AxelBjork/balancer_bot/doc/arch/send_path_asm_analysis.md

# IPC Send Path Assembly Analysis (-O3)

This document analyzes the generated x86-64 assembly of the SIL application's IPC send path, from a publisher calling `bus.publish()` down to the `sendmsg()` system call in the UDP Bridge, when compiled with `-O3` optimizations. The implementation is hyper-optimized for zero dynamic allocations and zero user-space memory copies.

## Complete Send Path Trace

When a service (for example, `RevisionService`) publishes a message, the following execution path occurs:

### 1. The Publisher Call
The publisher calls `bus.publish<MsgId::RevisionResponse>(payload)`. This forwards a `const void*` pointer pointing to the payload into `ipc::MessageBus::dispatch(MsgId, const void*)`. 

Because `dispatch` handles all message types symmetrically, it is compiled as a distinct out-of-line function (`<ipc::MessageBus::dispatch>`).

### 2. MessageBus `dispatch` (The Core Loop)
Inside `MessageBus::dispatch`, the code performs a lock-free lookup in the `std::unordered_map` to find the `std::vector<std::function>` associated with the `MsgId`.

Once the vector is found, the assembly loops through it. The compiler generates an indirect jump to the type-erased `std::function` handler:
```nasm
  # Setup loop bounds
  mov    rbx,QWORD PTR [rax+0x10]  # rbx = std::vector::begin()
  mov    rbp,QWORD PTR [rax+0x18]  # rbp = std::vector::end()

  # ... loop condition ...

  # The Indirect Call
  mov    rdi,rbx                   # rdi = functor lambda pointer
  mov    rsi,r12                   # rsi = const void* payload pointer
  call   QWORD PTR [rbx+0x18]      # Indirect jump to std::function handler
```
**Optimization Analysis:** Because the `handlers_` map holds type-erased function pointers, the compiler cannot devirtualize this call, even with aggressive inlining. The jump is inherently dynamic. This is the primary (and virtually only) overhead of the `MessageBus` design.

### 3. The `std::function` Handler (`forward_to_udp` lambda)
The indirect call lands inside the `<lambda(const void*)>::_M_invoke` function generated for `UdpBridge`.

This function acts entirely lock-free and zeroes out copying overhead:
1. **Atomic Peer Check**: It verifies the UDP active peer safely.
2. **`msg_hdr` and `iovec` Stack Emplacement**: It builds the vector arrays on the stack, forwarding exactly what the typed payload pointer views.
3. **Socket Send**: Calls `sendmsg()`.

```nasm
<std::_Function_handler<void (RevisionResponsePayload const&), ...>::_M_invoke(std::_Any_data const&, RevisionResponsePayload const&)>:
	mov    (%rdi),%rdx                # 1. Lock-free load of active peer (packed 64-bit struct representing IP + Port)
	mov    0x20(%rdx),%rax
	mov    %rax,%rcx
	shr    $0x20,%rcx
	test   %cx,%cx
	jne    <..._M_invoke+0x1b>		  # If ip and port are 0, return
	test   %eax,%eax
	je     <..._M_invoke+0xc0>
	sub    $0x88,%rsp				 # 2. Setup local structs (sockaddr_in, msghdr, and iovec[2])
	mov    $0x2,%edi
	pxor   %xmm0,%xmm0
	mov    $0x7d1,%r8d          	 # MsgId = 2001 (RevisionResponse)
	mov    %eax,0x14(%rsp)
	lea    0xe(%rsp),%rax
	movq   $0x0,0x18(%rsp)
	mov    %di,0x10(%rsp)
	mov    0x8(%rdx),%edi
	xor    %edx,%edx
	mov    %rax,0x20(%rsp)    	     # 3. Build iovec array and msghdr
	lea    0x10(%rsp),%rax
	mov    %rsi,0x30(%rsp)
	lea    0x40(%rsp),%rsi
	mov    %rax,0x40(%rsp)
	lea    0x20(%rsp),%rax
	movups %xmm0,0x4c(%rsp)
	movups %xmm0,0x5c(%rsp)
	mov    %cx,0x12(%rsp)
	mov    %r8w,0xe(%rsp)        	 # Store MsgId to local stack buffer
	movq   $0x2,0x28(%rsp)       	 # iov[0].iov_len = 2
	movq   $0x41,0x38(%rsp)      	 # iov[1].iov_len = 65 (sizeof(RevisionResponsePayload))
	movl   $0x10,0x48(%rsp)
	mov    %rax,0x50(%rsp)
	movq   $0x2,0x58(%rsp)
	movups %xmm0,0x68(%rsp)
	call   <sendmsg@plt>	 	 	 # 4. Trigger the syscall
	add    $0x88,%rsp
	ret
	nopw   0x0(%rax,%rax,1)
	nop
	nopl   (%rax)
	data16 cs nopw 0x0(%rax,%rax,1)
```

**Optimization Analysis:** This optimization is beautiful. 
- **Zero Allocations:** There are no `operator new` instantiations. Everything is placed exclusively on the 136-byte stack allocation.
- **Zero Copies:** There are absolutely zero `memcpy` operations. Instead of concatenating the MsgId and Payload into a single memory block first, the generated assembly constructs scatter/gather structures natively mapped into `iovec`. 
- **Template Devirtualization:** Because `RevisionResponse` is templated, the compiler has resolved `sizeof(Payload)` to a hardcoded constant (`0x41` or 65 bytes) and the `MsgId` literal `0x7d1` (2001).

### 4. The System Call Boundary
Immediately after preparing the scatter-gather definitions on the stack, the system jumps via PLT wrapper straight into the Linux Kernel.

```nasm
	call   <sendmsg@plt>         # PLT jump into libc / kernel
```

From here, execution traps into the Linux kernel (crossing via `syscall`). The kernel itself copies the fragments of memory mapped by `iovec` into a continuous kernel socket buffer (`sk_buff`) and loops it back over the `lo` loopback interface to Python (Pytest).

---

## Conclusions on Performance

- **The Good**: Serialization is virtually free, and completely eradicates user-space copying. Memory alignment and layout rules allow the compiler to map the `const void*` pointer natively across the kernel boundary.
- **The Overhead**: The abstraction of `MessageBus` (using `std::function` callback arrays) acts as an optimization barrier. The compiler cannot pierce the type erasure inside the dynamic vector, resulting in an unavoidable indirect call (`call QWORD PTR [...]`) for every subscriber.
- **Verdict**: For an application running at 100Hz, the cost of one indirect branch predictor miss per message dispatch is negligible (on the order of nanoseconds), whereas the zero copy pointer dispatch natively coalescing into UDP payloads guarantees we save significant CPU time, avoid cache pollution, and delete dynamic allocations entirely.

---

## 5. UdpBridge::rx_loop
This is a quick look at how the receiving loop manages to update the `active_peer_` without needing a mutex lock, exclusively using a native 64-bit atomic instruction path.

```nasm
<ipc::UdpBridge::rx_loop() + rx handler>:
	call   <recvfrom@plt>
	movdqa (%rsp),%xmm0
	test   %rax,%rax
	js     <...rx_loop()+0x16>
	mov    0x34(%rsp),%edi          # Load sender ip
	cmp    %edi,0x24(%rbx)          # Compare with current local loop cache
	jne    <...rx_loop()+0x153>     # If different... jump to update
	movzwl 0x32(%rsp),%edi          # Load sender port
	cmp    %di,0x22(%rbx)           # Compare
	je     <...rx_loop()+0x16b>

    # (Update path...)
	mov    0x30(%rsp),%rax          # Load incoming sender sockaddr tightly into %rax
	mov    %rax,0x20(%rbx)          # Atomic store to active_peer_!
```
Because `active_peer_` is packed into an 8-byte `PeerAddress` wrapper struct, the entire thread synchronization is reduced entirely to a single `mov` instruction (`mov %rax, 0x20(%rbx)`).
