AxelBjork/balancer_bot/hardware/frame/B-robot_EVO_2/Top_Shelf_[V10.stl

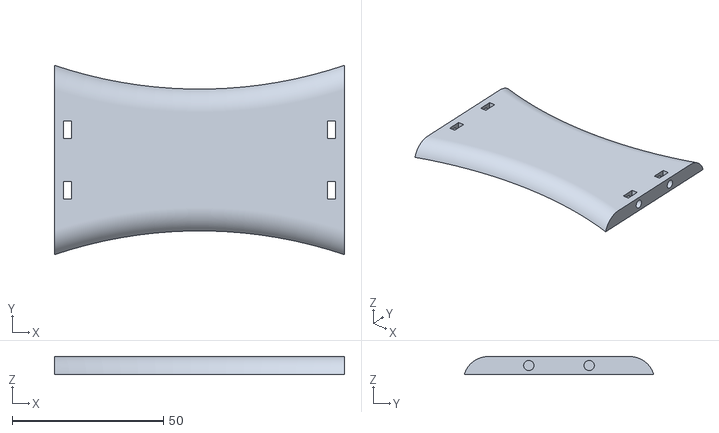
[picture p1: CAD file, 2025-08-23]
hardware/frame/B-robot_EVO_2/Top_Shelf_[V10.stl
96.0 x 62.7 x 6.00
