AxelBjork/balancer_bot/hardware/frame/custom/bumper_V3.stl

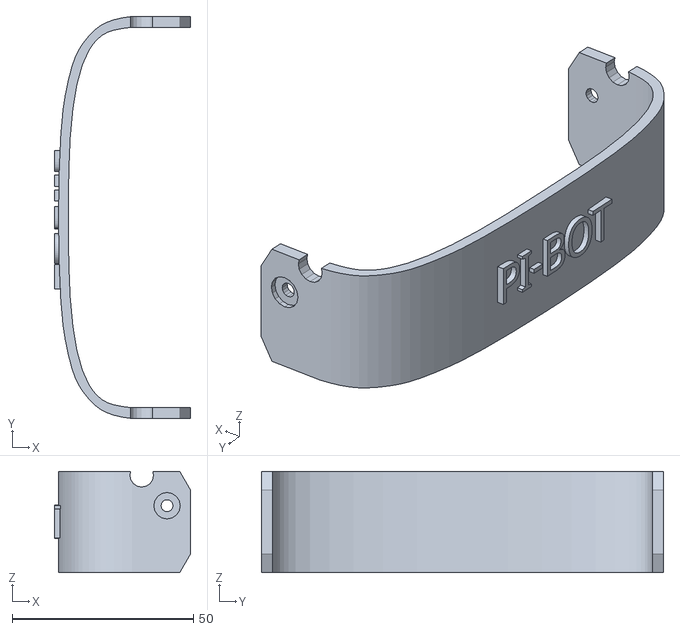
[picture p2: CAD file, 2025-08-23]
hardware/frame/custom/bumper_V3.stl
37.6 x 111.0 x 28.0
