AxelBjork/balancer_bot/hardware/frame/B-robot_EVO_2/Hub_[V10_ENLARGED.stl

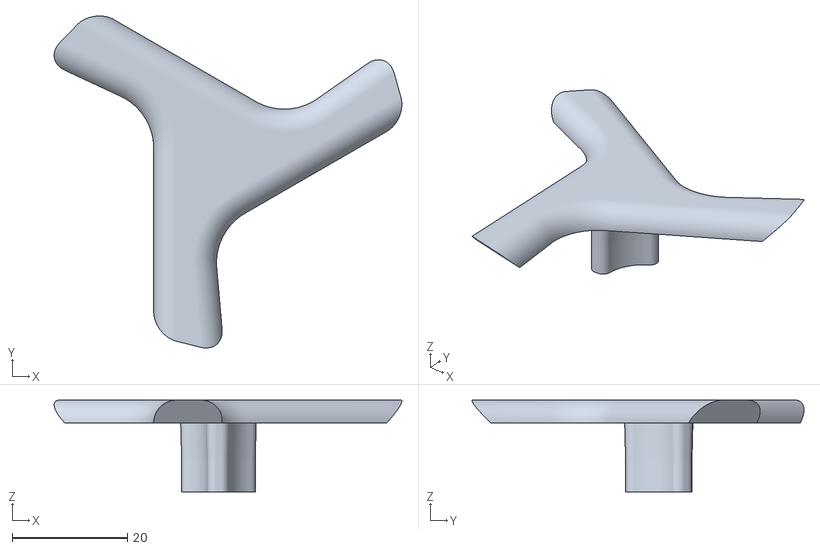
[picture p3: CAD file, 2025-08-23]
hardware/frame/B-robot_EVO_2/Hub_[V10_ENLARGED.stl
60.4 x 57.6 x 15.9
