AxelBjork/balancer_bot/hardware/frame/custom/side_panel_18650_v3.stl

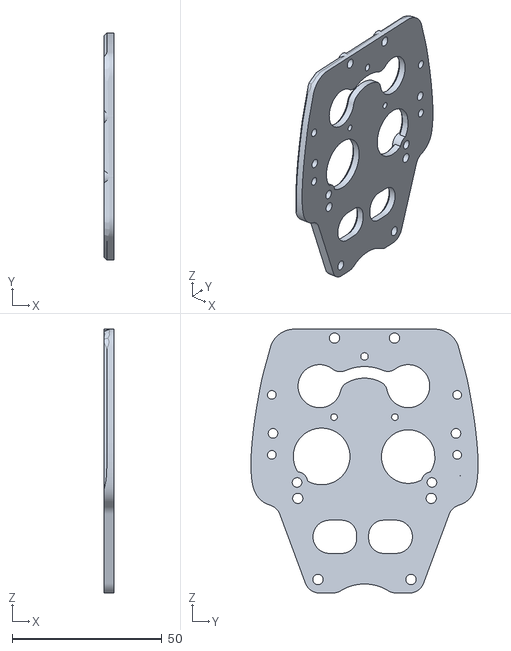
[picture p4: CAD file, 2025-08-23]
hardware/frame/custom/side_panel_18650_v3.stl
3.50 x 75.7 x 88.0
