AxelBjork/balancer_bot/hardware/frame/B-robot_EVO_2/Motor_Shelf_[V10.stl

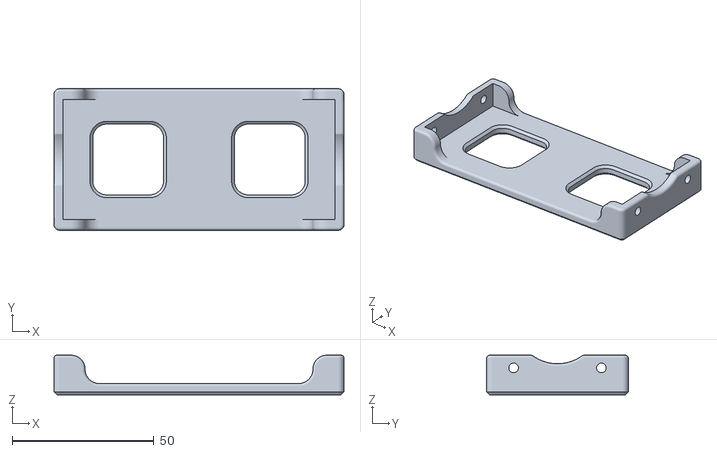
[picture p5: CAD file, 2025-08-23]
hardware/frame/B-robot_EVO_2/Motor_Shelf_[V10.stl
102.4 x 50.0 x 14.0
