AxelBjork/balancer_bot/hardware/frame/custom/pi_shelf_modded.stl

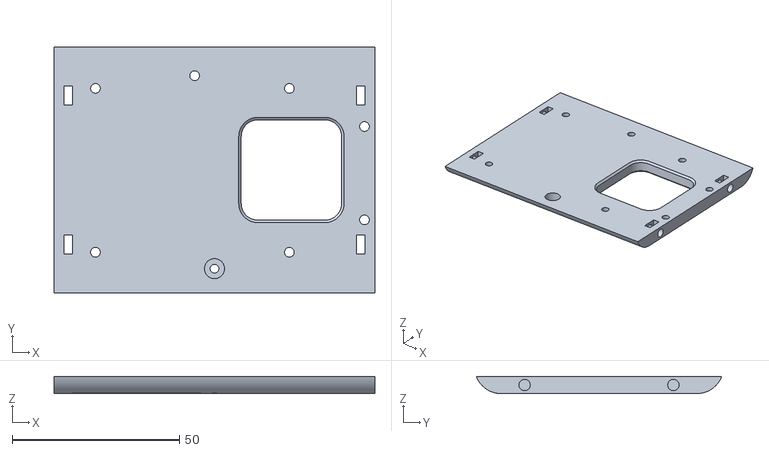
[picture p6: CAD file, 2025-08-23]
hardware/frame/custom/pi_shelf_modded.stl
96.0 x 73.5 x 5.15
