AxelBjork/balancer_bot/hardware/frame/B-robot_EVO_2/Wheel_[V11_FOR_O-RING_nytrile.stl

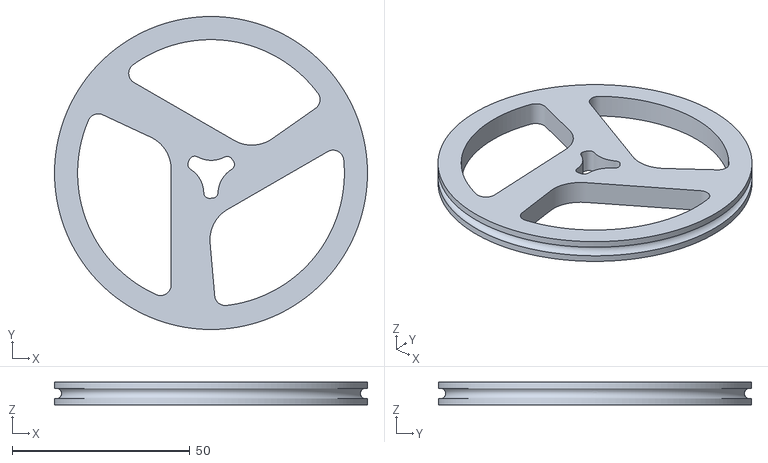
[picture p7: CAD file, 2025-08-23]
hardware/frame/B-robot_EVO_2/Wheel_[V11_FOR_O-RING_nytrile.stl
88.0 x 88.0 x 6.40
