AxelBjork/balancer_bot/tests/data/balance.csv

Starting IMU.
ISM330 requested ODR=833.000000; accel now=833.000000 | gyro now=833.000000
Trigger 'imu833' sampling_frequency now=833.000000
iio:device1: using trigger 'imu833'
iio:device0: using trigger 'imu833'
pitch=0.000° | dpitch=0.000° | yaw=0.000° | time=0.000
Polling for IMU data...
pitch=-88.198° | dpitch=108.163° | yaw=0.122° | time=16391.462
pitch=-86.141° | dpitch=255.646° | yaw=0.262° | time=16391.473
pitch=-83.046° | dpitch=372.118° | yaw=0.009° | time=16391.483
pitch=-78.429° | dpitch=465.046° | yaw=0.175° | time=16391.493
pitch=-73.685° | dpitch=511.833° | yaw=-0.306° | time=16391.503
pitch=-68.651° | dpitch=530.464° | yaw=-0.184° | time=16391.513
pitch=-62.908° | dpitch=529.630° | yaw=-0.122° | time=16391.523
pitch=-57.887° | dpitch=515.899° | yaw=0.481° | time=16391.533
pitch=-52.453° | dpitch=492.161° | yaw=0.350° | time=16391.544
pitch=-47.860° | dpitch=466.770° | yaw=0.271° | time=16391.553
pitch=-43.001° | dpitch=435.624° | yaw=0.306° | time=16391.564
pitch=-38.973° | dpitch=407.309° | yaw=0.586° | time=16391.574
pitch=-35.212° | dpitch=379.239° | yaw=0.560° | time=16391.583
pitch=-31.284° | dpitch=348.295° | yaw=0.227° | time=16391.594
pitch=-28.085° | dpitch=322.142° | yaw=0.271° | time=16391.604
pitch=-25.138° | dpitch=297.122° | yaw=0.411° | time=16391.613
pitch=-22.088° | dpitch=270.585° | yaw=0.507° | time=16391.624
pitch=-19.611° | dpitch=248.290° | yaw=0.446° | time=16391.634
pitch=-17.067° | dpitch=225.166° | yaw=0.236° | time=16391.645
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
pitch=-6.522° | dpitch=-17.197° | yaw=-3.745° | time=16411.017
pitch=-6.699° | dpitch=-15.829° | yaw=-4.025° | time=16411.028
pitch=-6.846° | dpitch=-14.889° | yaw=-3.990° | time=16411.038
pitch=-6.994° | dpitch=-12.688° | yaw=-3.089° | time=16411.048
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
