AxelBjork/balancer_bot/tests/data/imu_data.csv

pitch | dpitch | yaw | time
0.0 | 0.0 | 0.0 | 0.0
-1.5393454936739586 | 1.8878004788346265 | 0.002129301687433082 | 16391.462
-1.5034440709604355 | 4.461864419553423 | 0.004572762640225144 | 16391.473
-1.449426130611211 | 6.494684305936259 | 0.00015707963267948965 | 16391.483
-1.3688442790466329 | 8.11658387322955 | 0.0030543261909900766 | 16391.493
-1.2860458593320219 | 8.933171070360137 | -0.005340707511102648 | 16391.503
-1.1981859847866272 | 9.2583433632992 | -0.0032114058236695662 | 16391.513
-1.0979517258445928 | 9.243787317337567 | -0.002129301687433082 | 16391.523
-1.0103187441019577 | 9.004136157746226 | 0.008395033702092726 | 16391.533
-0.9154775525485858 | 8.589829899907812 | 0.006108652381980153 | 16391.544
-0.8353145800044861 | 8.146673349533932 | 0.0047298422729046335 | 16391.553
-0.7505090316500816 | 7.603073100707778 | 0.005340707511102648 | 16391.564
-0.68020716937975 | 7.108883123005584 | 0.01022762941668677 | 16391.574
-0.6145653362122434 | 6.618969201970775 | 0.009773843811168246 | 16391.583
-0.546008803193906 | 6.078894518233651 | 0.003961897402027128 | 16391.594
-0.4901757204226075 | 5.622438558959573 | 0.0047298422729046335 | 16391.604
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
