AxelBjork/balancer_bot/src/services/main/config.h

#pragma once
#include <atomic>
#include <cmath>

struct AxisCfg {
  int x = 0, y = 1, z = 2;
  bool invert_x = false, invert_y = false, invert_z = false;
};

struct Config {
  // ========= General =========
  static constexpr int run_seconds = 240;
  // Measured wheel geometry and verified driver configuration. Keep this as
  // the single source for production SPS<->distance conversion and the
  // simulator's physical actuator profiles.
  static constexpr double wheel_radius_m = 0.0412;
  static constexpr double wheel_diam_m = 2.0 * wheel_radius_m;
  static constexpr int motor_full_steps_per_rev = 200;
  static constexpr int microsteps_per_full_step = 32;
  static constexpr int commanded_steps_per_rev =
      motor_full_steps_per_rev * microsteps_per_full_step;
  static constexpr double steps_per_rev =
      static_cast<double>(commanded_steps_per_rev);
  static constexpr double meters_per_step =
      2.0 * M_PI * wheel_radius_m / steps_per_rev;
  // Internal scheduler/controller implementation rail.  The checked-in
  // controller configurations continue to use balance_max_sps=16000 while
  // simulator experiments can explore the electrical plant above that
  // nominal balance ceiling without changing the pulse/event representation.
  static constexpr double max_step_rate_sps = 64000.0;
  // The checked-in v12 configs deliberately retain this lower balance limit;
  // it is the fixed comparison surface for controller tuning.
  static constexpr double nominal_balance_max_sps = 16000.0;

  // ========= IMU =========
  static constexpr double sampling_hz = 833.000;  // available 12.5 26 52 104 208 416 833
  static constexpr AxisCfg accel_cfg = {.x = 0, .y = 2, .z = 1, .invert_x = true, .invert_z = true};
  static constexpr AxisCfg gyro_cfg = {.x = 0, .y = 2, .z = 1, .invert_x = true, .invert_z = true};

  static constexpr double g0 = 9.81;
  // The IMU's gyro LPF1 is configured in the ISM330 itself. The software rate
  // path retains only the measured structural notches.
  // No mounting, gyro-bias, gravity-recovery, or COM correction is learned.
  static constexpr double imu_accel_lpf_hz = 15.0;
  static constexpr double imu_gyro_lpf1_bandwidth_hz = 140.0;
  static constexpr int imu_gyro_lpf1_ftype = 0b010;
  // Fixed hardware-mode rejection. These are compiled production constants,
  // not PID-file or runtime estimator parameters.
  static constexpr double imu_gyro_notch_1_center_hz = 26.9;
  static constexpr double imu_gyro_notch_1_bandwidth_hz = 14.0;
  static constexpr double imu_gyro_notch_2_center_hz = 33.4;
  static constexpr double imu_gyro_notch_2_bandwidth_hz = 32.0;
  static constexpr double imu_gyro_derivative_lpf_hz = 10.0;
  // Gravity anchors DC pitch while the gyro carries short-term motion.
  static constexpr double imu_attitude_correction_hz = 0.5;
  static constexpr double imu_gravity_innovation_limit_rad = 2.5 * M_PI / 180.0;
  static constexpr double imu_max_sample_gap_periods = 4.0;
  static constexpr double imu_height_m = 0.070;
  static constexpr bool imu_lever_arm_correction_enabled = false;
  static constexpr double imu_specific_force_min_mps2 = 0.1 * g0;
  static constexpr double imu_specific_force_max_mps2 = 3.5 * g0;
  // Corrected axle velocity is used only by the 100 Hz outer damping/trim loop.
  // 10 Hz removes completed-step quantization without the phase lag that made
  // the proposed 1 Hz filter miss the rocking-disturbance catch.
  static constexpr double fc_velocity_hz = 10.0;

  // ========= Controller rates & limits =========
  static constexpr int control_hz = 400;  // Main control loop frequency
  // Pulse frequency can change much faster than the wheel itself; the phase-
  // error/missed-step plant supplies the physical acceleration limit.
  static constexpr double motor_slew_sps_per_s = 200000.0;
  // High field-speed requests may briefly spend a bounded actuator-only slew
  // budget. At 400 Hz, 250 SPS of credit permits one 300 kSPS/s update before
  // returning to the sustainable envelope. Credit is used
  // only for same-direction magnitude growth above 32 kSPS and recovers only
  // while the requested command is already reachable at the sustainable rate.
  static constexpr double motor_burst_slew_sps_per_s = 350000.0;
  static constexpr double motor_slew_burst_credit_sps = 250.0;
  static constexpr double motor_slew_burst_min_target_sps = 32000.0;
  static constexpr double motor_slew_burst_recovery_sps_per_s = 3000.0;
  // Same-direction field acceleration tapers above 20 kSPS as back-EMF uses
  // more of the available bus voltage. Same-direction magnitude braking in
  // this high-field interval gets a separate bounded allowance; a direction
  // reversal still uses the sustainable envelope and must pass through zero.
  static constexpr double motor_slew_taper_start_sps = 20000.0;
  static constexpr double motor_slew_taper_end_sps = 48000.0;
  static constexpr double motor_slew_at_taper_end_sps_per_s = 50000.0;
  static constexpr double motor_high_field_braking_slew_sps_per_s = 350000.0;

  // Motion authority is deliberately separate from fall protection.
  static constexpr double max_motion_pitch_setpoint_deg = 45.0;
  static constexpr double max_tilt_deg = 25.0;
  static constexpr double max_tilt_rad = max_tilt_deg * (M_PI / 180.0);
  // Explicit no-command fallover shutdown boundary. Motion setpoint and
  // fallover protection are intentionally separate safety concepts.
  static constexpr double fallover_shutdown_deg = 40.0;

  static constexpr int command_hz = 100;
  static constexpr int kPrintEvery = 100;
  static constexpr double deadzone = 0.05;
  // Public motion commands use robot-forward as positive. These electrical
  // inversions preserve the calibrated physical wheel polarity for the
  // mirrored motor installation; inversion remains confined to the hardware
  // boundary so controller, simulator, joystick, and telemetry signs agree.
  static constexpr bool invert_left = true;
  static constexpr bool invert_right = false;

};

static_assert(Config::sampling_hz > 0.0);
static_assert(Config::commanded_steps_per_rev == 6400);
static_assert(Config::microsteps_per_full_step == 32);
static_assert(Config::max_step_rate_sps == 64000.0);
static_assert(Config::nominal_balance_max_sps > 0.0 &&
              Config::nominal_balance_max_sps < Config::max_step_rate_sps);
static_assert(Config::max_motion_pitch_setpoint_deg > 0.0 &&
              Config::max_motion_pitch_setpoint_deg < 90.0);
static_assert(Config::fallover_shutdown_deg > Config::max_tilt_deg);
static_assert(Config::wheel_diam_m == 0.0824);
static_assert(Config::imu_accel_lpf_hz > 0.0 &&
              Config::imu_accel_lpf_hz < Config::sampling_hz / 2.0);
static_assert(Config::imu_gyro_lpf1_bandwidth_hz > 0.0 &&
              Config::imu_gyro_lpf1_bandwidth_hz < Config::sampling_hz / 2.0);
static_assert(Config::imu_gyro_lpf1_ftype == 0b010);
static_assert(Config::imu_gyro_notch_1_center_hz > 0.0 &&
              Config::imu_gyro_notch_1_center_hz < Config::sampling_hz / 2.0 &&
              Config::imu_gyro_notch_1_bandwidth_hz > 0.0);
static_assert(Config::imu_gyro_notch_2_center_hz > 0.0 &&
              Config::imu_gyro_notch_2_center_hz < Config::sampling_hz / 2.0 &&
              Config::imu_gyro_notch_2_bandwidth_hz > 0.0);
static_assert(Config::imu_gyro_derivative_lpf_hz > 0.0 &&
              Config::imu_gyro_derivative_lpf_hz < Config::sampling_hz / 2.0);
static_assert(Config::imu_attitude_correction_hz > 0.0 &&
              Config::imu_attitude_correction_hz < Config::sampling_hz / 2.0);
static_assert(Config::imu_gravity_innovation_limit_rad > 0.0 &&
              Config::imu_gravity_innovation_limit_rad < M_PI);
static_assert(Config::imu_max_sample_gap_periods > 1.0);
static_assert(Config::imu_height_m >= 0.0);
static_assert(Config::imu_specific_force_min_mps2 > 0.0);
static_assert(Config::imu_specific_force_max_mps2 >
              Config::imu_specific_force_min_mps2);

// ---------------------------------------------------------------------------

static std::atomic<bool> g_stop{false};
inline void on_signal(int) {
  g_stop.store(true, std::memory_order_relaxed);
}
