AxelBjork/balancer_bot/src/services/motor/stepper.h

// Stepper.h
#pragma once
#include <pigpiod_if2.h>
#include <cmath>
#include <stdexcept>

#include "services/main/config.h"

class Stepper {
 public:
  struct Pins {
    unsigned ena, step, dir;
  };

  Stepper(int pi, const Pins& pins, bool invert = false, bool energize_now = true)
      : pi_(pi), pins_(pins), invert_(invert) {
    if (pi_ < 0) throw std::runtime_error("pigpio not initialized");
    set_mode(pi_, pins_.ena, PI_OUTPUT);
    set_mode(pi_, pins_.step, PI_OUTPUT);
    set_mode(pi_, pins_.dir, PI_OUTPUT);

    // Keep the cached state in logical motor coordinates. Pin inversion is a
    // hardware-boundary detail applied only when the GPIO level is written.
    setDirNoWait(true);

    if (energize_now) {
      gpio_write(pi_, pins_.ena, 1);
      time_sleep(0.1);
    }
  }

  ~Stepper() {
    gpio_write(pi_, pins_.ena, 0);
  }

  // ---- helpers used by MotorRunner ----
  bool forwardFromSps(double sps) const noexcept {
    return sps >= 0.0;
  }
  void setDirNoWait(bool forward) {
    const bool level = invert_ ? !forward : forward;
    gpio_write(pi_, pins_.dir, level ? 1u : 0u);
    last_dir_forward_ = forward;
  }
  void setStepLow() {
    gpio_write(pi_, pins_.step, 0);
  }
  bool dirForward() const noexcept {
    return last_dir_forward_;
  }

  static unsigned clampSpsToHz(double sps, unsigned kMinPulseUs = 2,
                               double kMaxFreqHz = Config::max_step_rate_sps) {
    double f = std::fabs(sps);
    const double max_by_pulse = 1e6 / (2.0 * kMinPulseUs);
    if (f > kMaxFreqHz) f = kMaxFreqHz;
    if (f > max_by_pulse) f = max_by_pulse;
    return (f < 1.0) ? 0u : static_cast<unsigned>(std::llround(f));
  }

  // accessors for the wave engine
  int pi() const noexcept {
    return pi_;
  }
  unsigned stepPin() const noexcept {
    return pins_.step;
  }

 private:
  int pi_;
  Pins pins_;
  bool invert_{false};
  bool last_dir_forward_{true};
};
