AxelBjork/balancer_bot/tests/stepper_phase_actuator_test.cpp

#include "simulator/balancer_simulator.h"
#include "simulator/simulator_runner.h"
#include "simulator/stepper_phase_actuator.h"

#include <gtest/gtest.h>

#include <algorithm>
#include <array>
#include <cmath>
#include <filesystem>
#include <iostream>
#include <limits>
#include <utility>
#include <vector>

#include "services/main/config.h"

// These actuator tests use old zeroed-outer-loop setup spellings; keep the
// test source buildable while the behavioral assertions move to v12 fields.
#define velocity_damping_per_s velocity_gain_per_s
#define velocity_pitch_limit_deg outer_pitch_limit_deg
#define velocity_I adaptive_com_trim_gain_deg_per_mps_s

namespace {

constexpr double kPi = 3.14159265358979323846;

struct ScopedPidValues {
  ConfigPidValues values = ConfigPid::numeric_values();

  ~ScopedPidValues() {
    ConfigPid::apply_numeric(values);
  }
};

stepper_phase::Parameters nominal_stepper_parameters() {
  return stepper_phase::Parameters{
      .wheel_radius_m = BalancerSimulator::HardwareNominal::stepper_phase_wheel_radius,
      .full_steps_per_revolution = Config::motor_full_steps_per_rev,
      .microsteps_per_full_step = Config::microsteps_per_full_step,
      .current_limit_a = BalancerSimulator::HardwareNominal::stepper_current_limit_a,
      .torque_constant_nm_per_a =
          BalancerSimulator::HardwareNominal::stepper_torque_constant_nm_per_a,
  };
}

stepper_phase::ElectricalParameters nominal_electrical_parameters(double current_limit_a = 1.065,
                                                                  double bus_voltage_v = 11.1) {
  return stepper_phase::ElectricalParameters{
      .wheel_radius_m = BalancerSimulator::HardwareNominal::stepper_phase_wheel_radius,
      .full_steps_per_revolution = Config::motor_full_steps_per_rev,
      .microsteps_per_full_step = Config::microsteps_per_full_step,
      .phase_resistance_ohm = 2.3,
      .phase_inductance_h = 0.0044,
      .current_limit_a = current_limit_a,
      .bus_voltage_v = bus_voltage_v,
      .torque_constant_nm_per_a =
          BalancerSimulator::HardwareNominal::stepper_torque_constant_nm_per_a,
      .back_emf_constant_v_per_rad_s =
          BalancerSimulator::HardwareNominal::stepper_back_emf_constant_v_per_rad_s,
  };
}

SimulatorScenario stepper_recovery_scenario(double pitch_deg, double pitch_rate_dps,
                                            double velocity_sps, bool continuous_field = false) {
  SimulatorScenario scenario;
  scenario.name = "stepper_phase_recovery";
  scenario.physics_profile = PhysicsProfile::StepperPhase;
  scenario.duration_s = 2.0;
  scenario.initial_pitch_deg = pitch_deg;
  scenario.initial_fused_pitch_deg = pitch_deg;
  scenario.initial_pitch_rate_dps = pitch_rate_dps;
  scenario.initial_velocity_mps =
      velocity_sps * BalancerSimulator::HardwareNominal::stepper_phase_meters_per_step;
  scenario.com_angle_offset_rad = 0.0;
  if (continuous_field) {
    scenario.physics_override = BalancerSimulator::physics_for_profile(
        PhysicsProfile::StepperPhase);
    scenario.physics_override->stepper_phase_continuous_field = true;
  }
  return scenario;
}

struct PhaseModeLinearization {
  double effective_inertia_kg_m2 = 0.0;
  double magnetic_stiffness_nm_per_rad = 0.0;
  double effective_damping_nm_s_per_rad = 0.0;
  double natural_frequency_rad_s = 0.0;
  double natural_frequency_hz = 0.0;
  double period_s = 0.0;
  double damping_ratio = 0.0;
};

PhaseModeLinearization linearize_motor_relative_phase(const SimulatorPhysics& physics,
                                                       double current_limit_a,
                                                       double motor_damping = 0.0) {
  using Nominal = BalancerSimulator::HardwareNominal;
  const double mass = Nominal::total_mass_kg;
  const double first_moment = Nominal::first_mass_moment_kg_m;
  const double pitch_inertia = Nominal::pitch_inertia_about_axle_kg_m2;
  const double radius = Nominal::stepper_phase_wheel_radius;
  const double rotor_inertia =
      std::max(0.0, physics.stepper_rotating_inertia_kg_m2_per_motor);
  const double d11 = mass + 2.0 * rotor_inertia / (radius * radius);
  // The wheel/rotor inertia is tied to absolute wheel rotation x/r.  The
  // relative rotor/stator coordinate is only the magnetic phase coordinate.
  const double d12 = first_moment;
  const double d22 = pitch_inertia;
  const double determinant = d11 * d22 - d12 * d12;
  const double inverse_projected_inertia =
      (d22 / (radius * radius) + 2.0 * d12 / radius + d11) / determinant;
  const double effective_inertia = 1.0 / inverse_projected_inertia;
  constexpr double kElectricalCyclesPerMechanicalRevolution = 50.0;
  const double magnetic_stiffness =
      2.0 * BalancerSimulator::HardwareNominal::stepper_torque_constant_nm_per_a *
          std::max(0.0, current_limit_a) *
      kElectricalCyclesPerMechanicalRevolution;

  // z_dot = D^-1 a * J_eff * theta_dot for the pure relative-coordinate
  // mode, with a = [1/r, -1]. Project the existing chassis/pitch damping onto
  // that mode rather than inventing a second damping model.
  const double mode_x_per_theta_dot =
      effective_inertia * (d22 / radius + d12) / determinant;
  const double mode_q_per_theta_dot =
      effective_inertia * (-d12 / radius - d11) / determinant;
  const double base_damping =
      physics.cart_damping * mode_x_per_theta_dot * mode_x_per_theta_dot +
      physics.pitch_damping * mode_q_per_theta_dot * mode_q_per_theta_dot;
  const double total_damping = base_damping + 2.0 * std::max(0.0, motor_damping);
  const double natural_frequency_rad_s =
      magnetic_stiffness > 0.0 ? std::sqrt(magnetic_stiffness / effective_inertia) : 0.0;
  const double natural_frequency_hz = natural_frequency_rad_s / (2.0 * kPi);
  const double damping_denominator =
      2.0 * std::sqrt(std::max(0.0, effective_inertia * magnetic_stiffness));
  return PhaseModeLinearization{
      .effective_inertia_kg_m2 = effective_inertia,
      .magnetic_stiffness_nm_per_rad = magnetic_stiffness,
      .effective_damping_nm_s_per_rad = total_damping,
      .natural_frequency_rad_s = natural_frequency_rad_s,
      .natural_frequency_hz = natural_frequency_hz,
      .period_s = natural_frequency_rad_s > 0.0 ? 2.0 * kPi / natural_frequency_rad_s : 0.0,
      .damping_ratio = damping_denominator > 0.0 ? total_damping / damping_denominator : 0.0,
  };
}

struct PhaseRingdownSummary {
  double frequency_hz = 0.0;
  double damping_ratio = 0.0;
  double initial_phase_deg = 0.0;
  double peak_torque_nm_per_motor = 0.0;
  double maximum_current_error_a = 0.0;
  double final_phase_deg = 0.0;
  std::size_t zero_crossings = 0;
};

struct PhaseMassTerms {
  double d11 = 0.0;
  double d12 = 0.0;
  double d22 = 0.0;
  double determinant = 0.0;
};

PhaseMassTerms phase_mass_terms(const SimulatorPhysics& physics, double pitch_rad) {
  const auto matrix = BalancerSimulator::stepper_mass_matrix(physics, pitch_rad);
  return PhaseMassTerms{matrix.d11, matrix.d12, matrix.d22, matrix.determinant};
}

struct BalanceAcceleration {
  double x_ddot = 0.0;
  double pitch_ddot = 0.0;
};

BalanceAcceleration independently_expected_stepper_acceleration(
    const SimulatorPhysics& physics, double pitch_rad, double total_motor_torque_nm,
    double external_force_n = 0.0) {
  using Nominal = BalancerSimulator::HardwareNominal;
  // Keep this calculation independent of BalancerSimulator::stepper_mass_matrix().
  // The purpose of the invariant is to compare two derivations, not to call the
  // production helper twice.
  const double radius = Nominal::stepper_phase_wheel_radius;
  const double rotating_inertia =
      std::max(0.0, physics.stepper_rotating_inertia_kg_m2_per_motor);
  const double d11 = Nominal::total_mass_kg + 2.0 * rotating_inertia / (radius * radius);
  const double d12 = Nominal::first_mass_moment_kg_m * std::cos(pitch_rad);
  const double d22 = Nominal::pitch_inertia_about_axle_kg_m2;
  const double determinant = d11 * d22 - d12 * d12;
  const double H = Nominal::first_mass_moment_kg_m;
  const double total_mass = Nominal::total_mass_kg;
  const double pitch_rate = 0.0;
  const double rhs_x = total_motor_torque_nm / radius +
                       external_force_n - physics.cart_damping * 0.0;
  const double external_pitch_moment = external_force_n * (H / total_mass) * std::cos(pitch_rad);
  const double rhs_pitch = physics.gravity_mps2 * H * std::sin(pitch_rad) -
                           physics.pitch_damping * pitch_rate - total_motor_torque_nm +
                           external_pitch_moment;
  return BalanceAcceleration{
      .x_ddot = (d22 * rhs_x - d12 * rhs_pitch) / determinant,
      .pitch_ddot = (d11 * rhs_pitch - d12 * rhs_x) / determinant,
  };
}

PhaseRingdownSummary run_fixed_field_ringdown(const SimulatorPhysics& physics,
                                               bool electrical, double current_limit_a,
                                               double initial_phase_deg,
                                               double motor_damping_nm_s_per_rad,
                                               double dt_s = 1.0e-5,
                                               double duration_s = 0.20) {
  using Nominal = BalancerSimulator::HardwareNominal;
  const double radius = Nominal::stepper_phase_wheel_radius;
  const double electrical_cycles = Nominal::stepper_phase_electrical_cycles_per_rev;
  const auto mass_terms = phase_mass_terms(physics, 0.0);
  const double projected_inertia =
      1.0 / (mass_terms.d22 / (radius * radius) + 2.0 * mass_terms.d12 / radius +
             mass_terms.d11) * mass_terms.determinant;
  const double phase_error_rad = initial_phase_deg * kPi / 180.0;
  const double theta_initial = -phase_error_rad / electrical_cycles;
  const double mode_x =
      projected_inertia * (mass_terms.d22 / radius + mass_terms.d12) /
      mass_terms.determinant;
  const double mode_q =
      projected_inertia * (-mass_terms.d12 / radius - mass_terms.d11) /
      mass_terms.determinant;
  double x = mode_x * theta_initial;
  double q = mode_q * theta_initial;
  double x_dot = 0.0;
  double q_dot = 0.0;

  stepper_phase::Actuator ideal_actuator(stepper_phase::Parameters{
      .wheel_radius_m = radius,
      .full_steps_per_revolution = 200,
      .microsteps_per_full_step = 32,
      .current_limit_a = current_limit_a,
      .torque_constant_nm_per_a =
          BalancerSimulator::HardwareNominal::stepper_torque_constant_nm_per_a,
  });
  stepper_phase::ElectricalActuator electrical_actuator(nominal_electrical_parameters(
      current_limit_a, physics.stepper_bus_voltage_v));
  ideal_actuator.set_commanded_microstep_positions(0.0, 0.0);
  electrical_actuator.set_commanded_microstep_positions(0.0, 0.0);

  std::vector<double> times;
  std::vector<double> phases;
  times.reserve(static_cast<std::size_t>(duration_s / dt_s));
  phases.reserve(static_cast<std::size_t>(duration_s / dt_s));
  double peak_torque = 0.0;
  double max_current_error = 0.0;
  const std::size_t sample_count = static_cast<std::size_t>(duration_s / dt_s);
  for (std::size_t sample = 0; sample < sample_count; ++sample) {
    const double theta_motor = x / radius - q;
    if (electrical) {
      electrical_actuator.set_actual_relative_angles_for_test(theta_motor, theta_motor);
    } else {
      ideal_actuator.set_actual_relative_angles_for_test(theta_motor, theta_motor);
    }
    double phase_error = 0.0;
    double torque_per_motor = 0.0;
    double current_error = 0.0;
    if (electrical) {
      const auto output = electrical_actuator.evaluate(dt_s, x_dot, q_dot);
      phase_error = output.left.electrical_phase_error_rad;
      torque_per_motor = output.left.torque_nm;
      current_error = std::max(std::abs(output.left.current_ref_a - output.left.current_a),
                               std::abs(output.left.current_ref_b - output.left.current_b));
    } else {
      const auto output = ideal_actuator.evaluate(dt_s, x_dot, q_dot);
      phase_error = output.left.electrical_phase_error_rad;
      torque_per_motor = output.left.torque_nm;
    }
    const double relative_velocity_rad_s = x_dot / radius - q_dot;
    const double total_torque =
        2.0 * (torque_per_motor - motor_damping_nm_s_per_rad * relative_velocity_rad_s);
    const double pitch_sin = std::sin(q);
    const double rhs_x = total_torque / radius +
                         Nominal::first_mass_moment_kg_m * q_dot * q_dot * pitch_sin -
                         physics.cart_damping * x_dot;
    const double rhs_q = Nominal::gravity * Nominal::first_mass_moment_kg_m * pitch_sin -
                         physics.pitch_damping * q_dot - total_torque;
    const double x_ddot =
        (mass_terms.d22 * rhs_x - mass_terms.d12 * rhs_q) / mass_terms.determinant;
    const double q_ddot =
        (-mass_terms.d12 * rhs_x + mass_terms.d11 * rhs_q) / mass_terms.determinant;
    x_dot += x_ddot * dt_s;
    q_dot += q_ddot * dt_s;
    x += x_dot * dt_s;
    q += q_dot * dt_s;
    times.push_back(static_cast<double>(sample) * dt_s);
    phases.push_back(phase_error);
    peak_torque = std::max(peak_torque, std::abs(torque_per_motor));
    max_current_error = std::max(max_current_error, current_error);
  }

  std::vector<double> zero_crossings;
  for (std::size_t i = 1; i < phases.size(); ++i) {
    if (phases[i - 1] == 0.0 || phases[i - 1] * phases[i] < 0.0) {
      const double denominator = phases[i] - phases[i - 1];
      const double fraction = std::abs(denominator) > 1e-15
                                  ? -phases[i - 1] / denominator
                                  : 0.0;
      zero_crossings.push_back(times[i - 1] + fraction * dt_s);
    }
  }
  double frequency_hz = 0.0;
  if (zero_crossings.size() >= 3) {
    double period_sum = 0.0;
    std::size_t periods = 0;
    for (std::size_t i = 2; i < zero_crossings.size(); ++i) {
      period_sum += zero_crossings[i] - zero_crossings[i - 2];
      ++periods;
    }
    if (periods > 0 && period_sum > 0.0) {
      frequency_hz = static_cast<double>(periods) / period_sum;
    }
  }
  std::vector<std::pair<double, double>> peaks;
  for (std::size_t i = 1; i + 1 < phases.size(); ++i) {
    const bool local_max = phases[i] >= phases[i - 1] && phases[i] >= phases[i + 1];
    const bool local_min = phases[i] <= phases[i - 1] && phases[i] <= phases[i + 1];
    if ((local_max || local_min) && std::abs(phases[i]) > 1e-8) {
      peaks.emplace_back(times[i], std::abs(phases[i]));
    }
  }
  double damping_ratio = 0.0;
  if (peaks.size() >= 3 && frequency_hz > 0.0) {
    double sum_t = 0.0;
    double sum_log = 0.0;
    double sum_tt = 0.0;
    double sum_tlog = 0.0;
    for (const auto& [time, amplitude] : peaks) {
      const double log_amplitude = std::log(amplitude);
      sum_t += time;
      sum_log += log_amplitude;
      sum_tt += time * time;
      sum_tlog += time * log_amplitude;
    }
    const double count = static_cast<double>(peaks.size());
    const double denominator = count * sum_tt - sum_t * sum_t;
    const double slope = std::abs(denominator) > 1e-15
                             ? (count * sum_tlog - sum_t * sum_log) / denominator
                             : 0.0;
    const double decay_rate = std::max(0.0, -slope);
    const double damped_frequency_rad_s = 2.0 * kPi * frequency_hz;
    damping_ratio = decay_rate /
                    std::sqrt(decay_rate * decay_rate +
                              damped_frequency_rad_s * damped_frequency_rad_s);
  }
  return PhaseRingdownSummary{
      .frequency_hz = frequency_hz,
      .damping_ratio = damping_ratio,
      .initial_phase_deg = initial_phase_deg,
      .peak_torque_nm_per_motor = peak_torque,
      .maximum_current_error_a = max_current_error,
      .final_phase_deg = phases.empty() ? 0.0 : phases.back() * 180.0 / kPi,
      .zero_crossings = zero_crossings.size(),
  };
}

struct FreeWheelRingdownSummary {
  int step_events = 0;
  double first_step_time_s = 0.0;
  double second_step_time_s = 0.0;
  double commanded_mechanical_displacement_rad = 0.0;
  double final_mechanical_angle_rad = 0.0;
  double frequency_hz = 0.0;
  double damping_ratio = 0.0;
  double peak_torque_nm = 0.0;
};
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
