AxelBjork/balancer_bot/tests/simulator/stepper_phase_actuator.h

#pragma once

#include <cstdint>

#include "services/main/config.h"

namespace stepper_phase {

// Ideal-current diagnostic actuator for a two-phase stepper.  The current
// amplitude is the norm of the two winding-current vector, not the current in
// one winding.  This is the same convention used by ElectricalParameters.
// The maintained electrical variant below adds bounded R/L and back-EMF
// current evolution; this class isolates the phase/mechanical topology.
struct Parameters {
  double wheel_radius_m = Config::wheel_radius_m;
  int full_steps_per_revolution = Config::motor_full_steps_per_rev;
  int microsteps_per_full_step = Config::microsteps_per_full_step;
  // Nominal DRV8825 full-scale vector-current setting.  At a given field
  // angle the two phase references have this Euclidean norm.
  double current_limit_a = 1.065;
  // The motor's 0.45 N m / 1.5 A-per-winding holding datum maps to the
  // vector convention as 0.45 / (sqrt(2) * 1.5) N m/A.
  double torque_constant_nm_per_a = 0.21213203435596426;
};

struct PhaseCommand {
  double a = 0.0;
  double b = 0.0;
};

struct MotorOutput {
  double commanded_microstep_position = 0.0;
  std::int64_t commanded_microstep_index = 0;
  double commanded_mechanical_angle_rad = 0.0;
  double commanded_field_electrical_angle_rad = 0.0;
  double commanded_field_velocity_mps = 0.0;
  double actual_relative_mechanical_angle_rad = 0.0;
  double actual_relative_mechanical_velocity_mps = 0.0;
  double actual_rotor_electrical_angle_rad = 0.0;
  // Unwrapped field-minus-rotor displacement; this retains complete
  // electrical cycles that the wrapped error intentionally discards.
  double unwrapped_electrical_phase_error_rad = 0.0;
  double field_rotor_relative_velocity_rad_s = 0.0;
  double electrical_phase_error_rad = 0.0;
  PhaseCommand phase{};
  double torque_nm = 0.0;
};

struct Output {
  MotorOutput left{};
  MotorOutput right{};
  double summed_torque_nm = 0.0;
};
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
