AxelBjork/balancer_bot/(commit log)

2025-08-18 add stepper.h, motor test
2025-08-23 add IMU reader, control loops
2025-08-23 add .stl parts and readme
    [Hub_[V10_ENLARGED.stl, Motor_Shelf_[V10.stl, Top_Shelf_[V10.stl, Wheel_[V11_FOR_O-RING_nytrile.stl, bumper_V3.stl, pi_shelf_modded.stl, side_panel_18650_v3.stl]
2025-08-25 add readme for auto imu setup
2025-08-28 store gyro data
2025-08-30 add buffered IMU reads
    [gyro_data_running.csv, imu_held.csv, imu_still.csv]
2025-08-30 add balance 100hz data
    [balance.csv]
2025-10-19 Feature/control tune 2 (#4)
    * add csv test
    boost
    cleanup config, add motor invert
    * add pitch lpf
    add logging
    update control loop
    add latency test
    * auto format everything
    * add stepper latency test
    more control
    update params, lqr loop
    update loop
    * use px4 PID
    * remove px4_submodule
    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
    [imu_data.csv]
2026-01-17 add velocity control
    add cross compile
    fix linter
2026-01-17 xbox control
    run_time_vars
    faster sim
    fix avg speed
    remove sim speed
    wip: fix velocity state read
    [analyze_sim.py]
2026-05-02 Refactor Into Services, fix hardware control (#6)
    * split px4
    * add services
    * feat: Add C++26 reflection support and UDP bridge for IPC communication
    - Introduced C++26 reflection capabilities through a new cmake/reflection.cmake file.
    - Added a generator (generate_balancer_bindings.cpp) to create Python bindings for IPC payloads using reflection.
    - Implemented a UDP bridge in the control_app to relay messages to Python clients.
    - Enhanced the ImuService to optionally enable hardware reading.
    - Created a new sil_app for hardware-in-the-loop simulation/testing.
    - Added tests for UDP bridge functionality and IPC message relay.
    - Updated .gitignore to exclude Python bytecode files and gener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
    [Hub_[V10_ENLARGED.stl, Motor_Shelf_[V10.stl, Top_Shelf_[V10.stl, Wheel_[V11_FOR_O-RING_nytrile.stl, balance.csv, balance_raw.csv, bumper_V3.stl, gyro_data_running.csv]
2026-07-22 control: tune rate loop and add stability coverage
    [balancer_simulator.h, config.h, control_loop_test.cpp, control_service.h, fuzz_scenario_format.h, generate_corpora.py, motor_runner_test.cpp]
2026-07-22 telemetry: add dashboard, analysis tooling, and captures
    [locked_runaway.csv, manual_intervention.csv, quiet_operation.csv, runaway_onset.csv, steady_state_100hz.csv, steady_state_10s_400hz.csv, steady_state_spectrum.csv]
2026-07-22 simulator: refactor execution and add kick-back behavior
    [telemetry.csv]
2026-07-22 dashboard: rewrite web interface
    [telemetry.csv]
2026-07-22 telemetry: integrate messages and drive validation
    [session0_51p2_to_54p6.csv, session1_3p8_to_5p5.csv, session1_55p8_to_58p0.csv]
2026-08-15 control: add COM trim and pitch-authority diagnostics
2026-08-15 simulator: add and validate stepper-phase electrical behavior
    [optical_event_timing.csv, optical_video_raw.csv]
2026-08-17 control: correct driving behavior and electrical validation
    * control: consolidate balancing controller and simulator tooling
    Capture the current acceleration and attitude balancing controller, velocity reference planning, simulator behavior, telemetry support, and associated configuration in one coherent baseline. Align the project documentation with the current implementation and replace obsolete audit material with interactive plant and stepper-electrical references.
    * control: correct driving behavior and electrical validation
    Correct forward-driving polarity and stepper electrical configuration across the controller, simulator, PID fixtures, and generated telemetry bindings. Extend s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
    [balancer_msgs.h, balancer_simulator.cpp, balancer_simulator.h, config.h, config_pid_io.cpp, config_pid_values.h, control_app.h, control_loop_test.cpp]
2026-08-23 Snapshot current repository state
2026-08-28 Refine IMU filtering and motor reversal scheduling
    Remove the legacy simulator-only gyro filter path, align IMU documentation and configuration, and improve motor direction reversal handling with phase-preserving simulator scheduling. Update latency, simulator, dashboard, and regression coverage for the new behavior.
    [balancer_msgs.h, balancer_simulator.cpp, balancer_simulator.h, config.h, control_service.cpp, imu_pitch_estimator.cpp, imu_pitch_estimator.h]
2026-08-30 Refactor simulator outer-loop recovery and telemetry
    Add brace-based fallover fixtures and outer-loop A/B coverage, improve continuous velocity reference planning and simulator motor dynamics, extend telemetry for feedback decomposition, and remove obsolete pitch-authority diagnostic tooling and messages.
    [balancer_msgs.h, balancer_simulator.cpp, balancer_simulator.h, config.h, control_loop_test.cpp, control_service.cpp, control_service.h]
